charypar/embedded-playground/Readme.md

# Niche device firmware

## Flashing bootloader

Using a probe

```sh
make flash-bootloader
```

## Flashing firmware

For Spinny, for example:

With a probe:

```sh
make flash-spinny
```

Over USB

```sh
make upload-spinny
```
