charypar/embedded-playground/blinky/README.md

# Device specific code

This is not strictly speaking completely separated yet.
