charypar/embedded-playground/cross/README.md

# Cross-platform code

This contains code that runs just as happily on device as it does on the host. Currently mainly used to run tests on the host.
