charypar/embedded-playground/spinny/software/README.md

# Spinny, the rotary USB controller prototype

A device with a rotary encoder and four buttons all directly wired to the MCU.

Uses stm32f103c8t6 microcontroller with ARM Cortex-M0+ core.
