charypar/embedded-playground/spinny/hardware/production/enclosure/back-case.stl

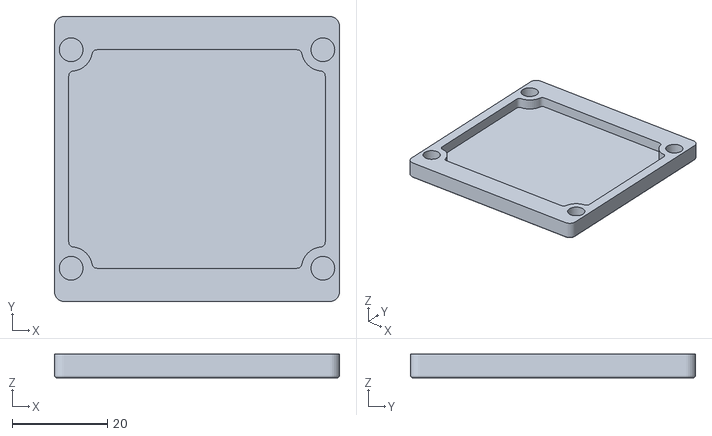
[picture p1: CAD file, 2022-08-29]
spinny/hardware/production/enclosure/back-case.stl
60.0 x 60.0 x 5.00
