charypar/embedded-playground/spinny/hardware/production/enclosure/button.stl

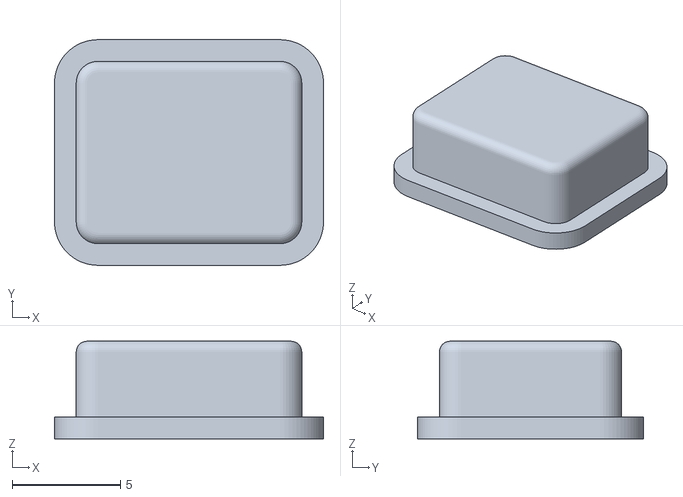
[picture p2: CAD file, 2022-08-29]
spinny/hardware/production/enclosure/button.stl
12.4 x 10.4 x 4.50
