charypar/embedded-playground/spinny/hardware/production/enclosure/front-case.stl

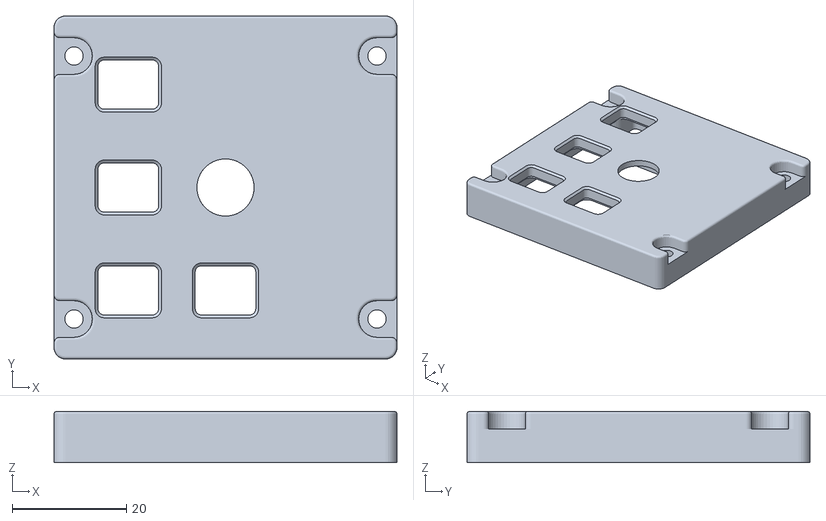
[picture p3: CAD file, 2022-08-29]
spinny/hardware/production/enclosure/front-case.stl
60.0 x 60.0 x 9.00
