charypar/embedded-playground/spinny/hardware/production/enclosure/knob.stl

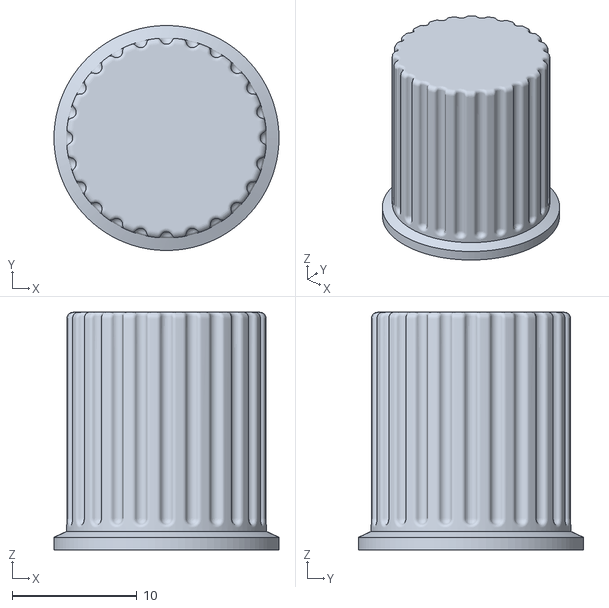
[picture p4: CAD file, 2022-08-29]
spinny/hardware/production/enclosure/knob.stl
18.0 x 18.0 x 19.0
