charypar/embedded-playground/spinny/hardware/Spinny.kicad_pcb

## KiCad design spinny/hardware/Spinny.kicad_pcb (2022-08-29)

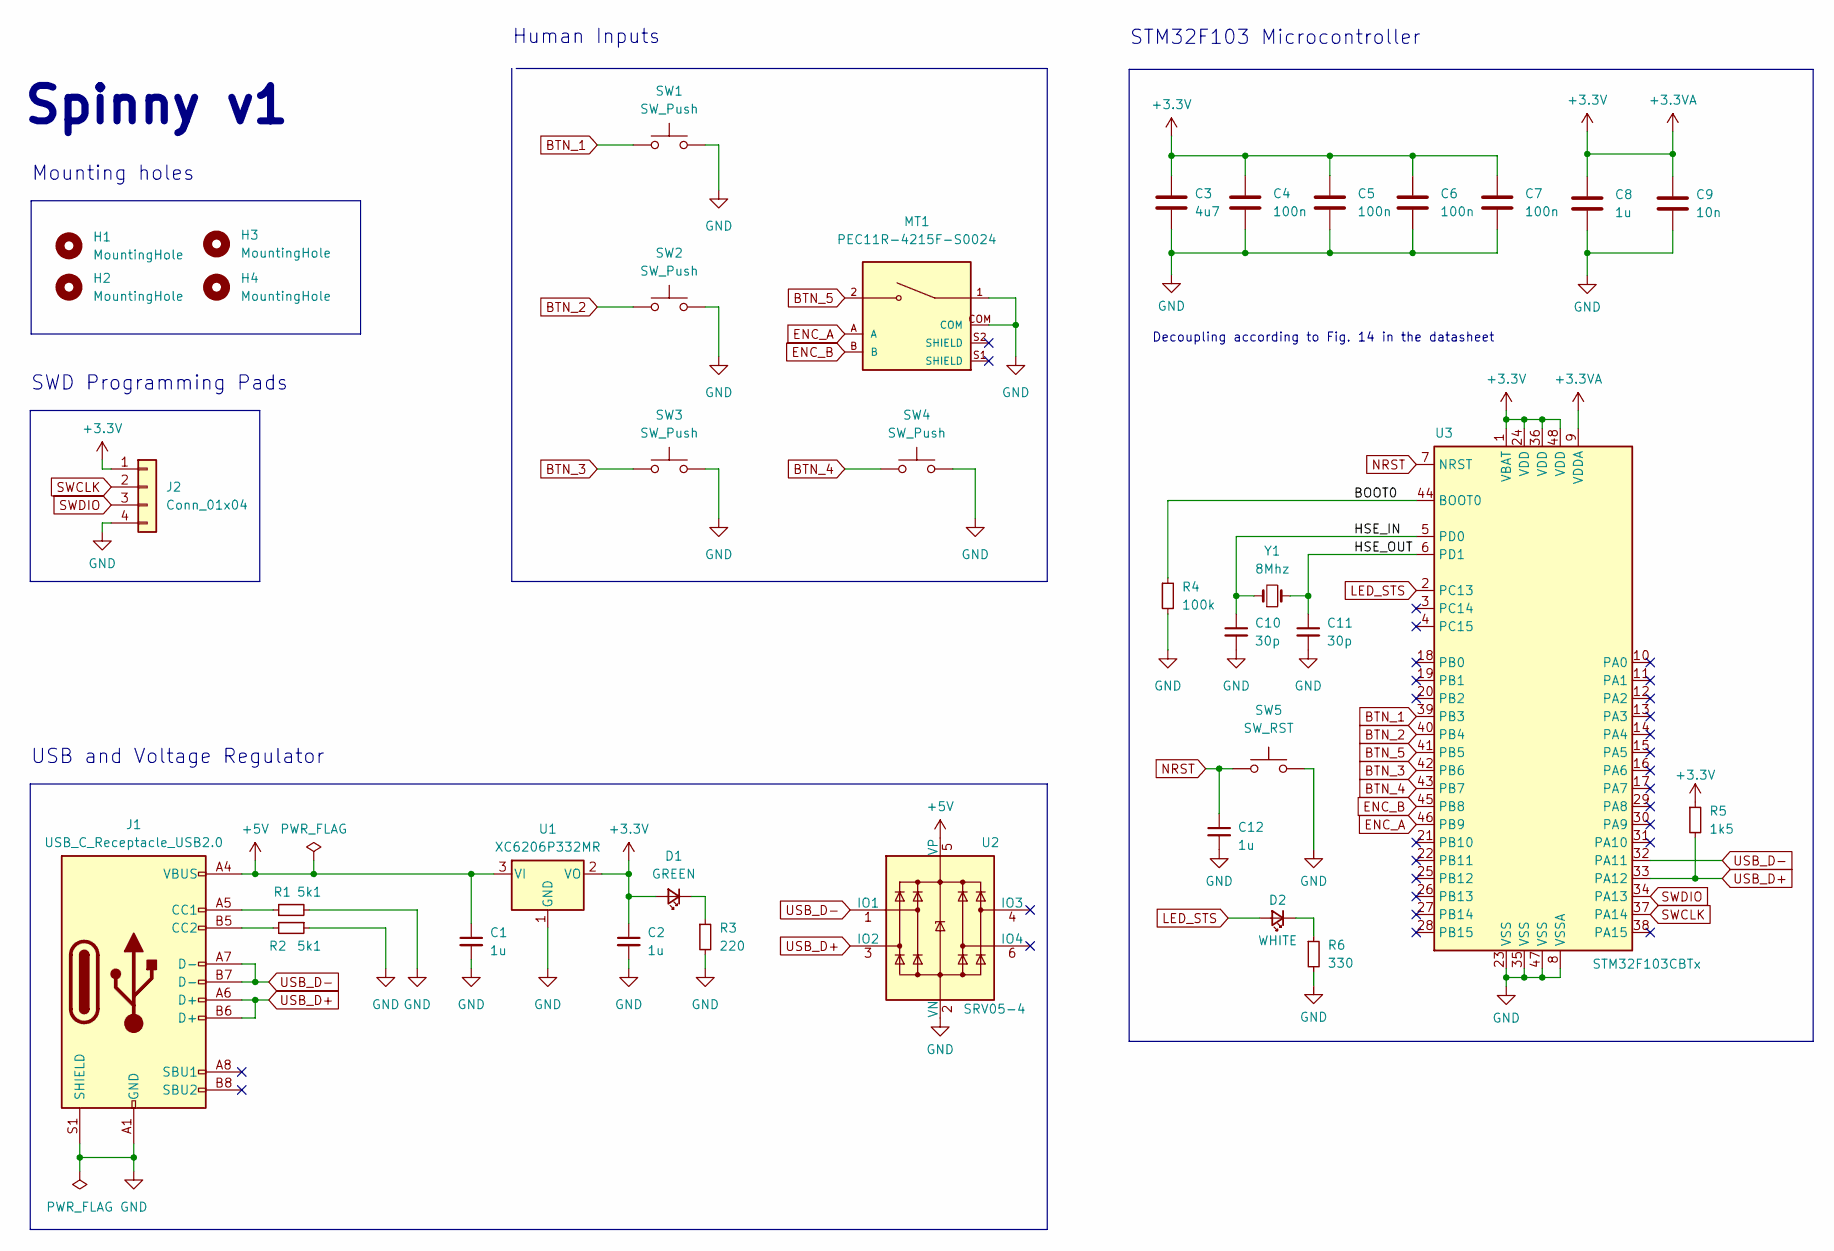
[picture p5: schematic Spinny.kicad_sch, Spinny Flight Simulation Control]

Parts:
C1, C2, C8, C12: 1u; C_0402_1005Metric; LCSC C52923
C3: 4u7; C_0603_1608Metric; LCSC C19666
C4, C5, C6, C7: 100n; C_0402_1005Metric; LCSC C1525
C9: 10n; C_0402_1005Metric; LCSC C15195
C10, C11: 30p; C_0402_1005Metric; LCSC C1570
D1: GREEN; LED_0603_1608Metric; LCSC C72043
D2: WHITE; LED_0603_1608Metric; LCSC C2290
H1, H2, H3, H4: MountingHole; MountingHole_3.2mm_M3
J1: USB_C_Receptacle_USB2.0; USB_C_Receptacle_HRO_TYPE-C-31-M-12; LCSC C709357
J2: Conn_01x04; PinHeader_1x04_P2.54mm_Vertical
MT1: PEC11R-4215F-S0024; XDCR_PEC11R-4215F-S0024; PARTREV Rev. 09/19
R1, R2: 5k1; R_0402_1005Metric; LCSC C25905
R3: 220; R_0402_1005Metric; LCSC C25091
R4: 100k; R_0402_1005Metric; LCSC C25741
R5: 1k5; R_0402_1005Metric; LCSC C25867
R6: 330; R_0402_1005Metric; LCSC C25104
SW1, SW2, SW3, SW4: SW_Push; SW_TS02-66-43-BK-100-LCR-D
SW5: SW_RST; SMD-SW-4_5.1x5.1x1.5; LCSC C318884
U1: XC6206P332MR; SOT-23; LCSC C5446
U2: SRV05-4; SOT-23-6; LCSC C85364
U3: STM32F103CBTx; LQFP-48_7x7mm_P0.5mm; LCSC C8304
Y1: 8Mhz; Crystal_SMD_5032-2Pin_5.0x3.2mm; LCSC C115962

Connections:
+5V: C1.1, J1.A4 (VBUS), J1.A9 (VBUS), J1.B4 (VBUS), J1.B9 (VBUS), U1.3 (VI), U2.5 (VP)
/BOOT0: R4.1, U3.44 (BOOT0)
/HSE_IN: C10.1, U3.5 (PD0), Y1.1
/HSE_OUT: C11.1, U3.6 (PD1), Y1.2
BTN_1: SW1.1, U3.39 (PB3)
BTN_2: SW2.1, U3.40 (PB4)
BTN_3: SW3.1, U3.42 (PB6)
BTN_4: SW4.1, U3.43 (PB7)
BTN_5: MT1.2, U3.41 (PB5)
ENC_A: MT1.A, U3.46 (PB9)
ENC_B: MT1.B, U3.45 (PB8)
GND: C1.2, C2.2, C3.2, C4.2, C5.2, C6.2, C7.2, C8.2, C9.2, C10.2, C11.2, C12.2, J1.A1 (GND), J1.A12 (GND), J1.B1 (GND), J1.B12 (GND), J1.S1 (SHIELD), J2.4, MT1.1, MT1.COM, R1.2, R2.1, R3.2, R4.2, R6.2, SW1.2, SW2.2, SW3.2, SW4.2, SW5.2, U1.1 (GND), U2.2 (VN), U3.8 (VSSA), U3.23 (VSS), U3.35 (VSS), U3.47 (VSS)
LED_STS: D2.2 (A), U3.2 (PC13)
NRST: C12.1, SW5.1, U3.7 (NRST)
unnamed: D1.1 (K), R3.1
unnamed: D2.1 (K), R6.1
unnamed: J1.A5 (CC1), R1.1
unnamed: J1.B5 (CC2), R2.2
SWCLK: J2.2, U3.37 (PA14)
SWDIO: J2.3, U3.34 (PA13)
USB_D+: J1.A6 (D+), J1.B6 (D+), R5.2, U2.3 (IO2), U3.33 (PA12)
USB_D-: J1.A7 (D-), J1.B7 (D-), U2.1 (IO1), U3.32 (PA11)

Notes on the sheet:
SWD Programming Pads
Decoupling according to Fig. 14 in the datasheet
Spinny v1
Human Inputs
STM32F103 Microcontroller
Mounting holes
USB and Voltage Regulator

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
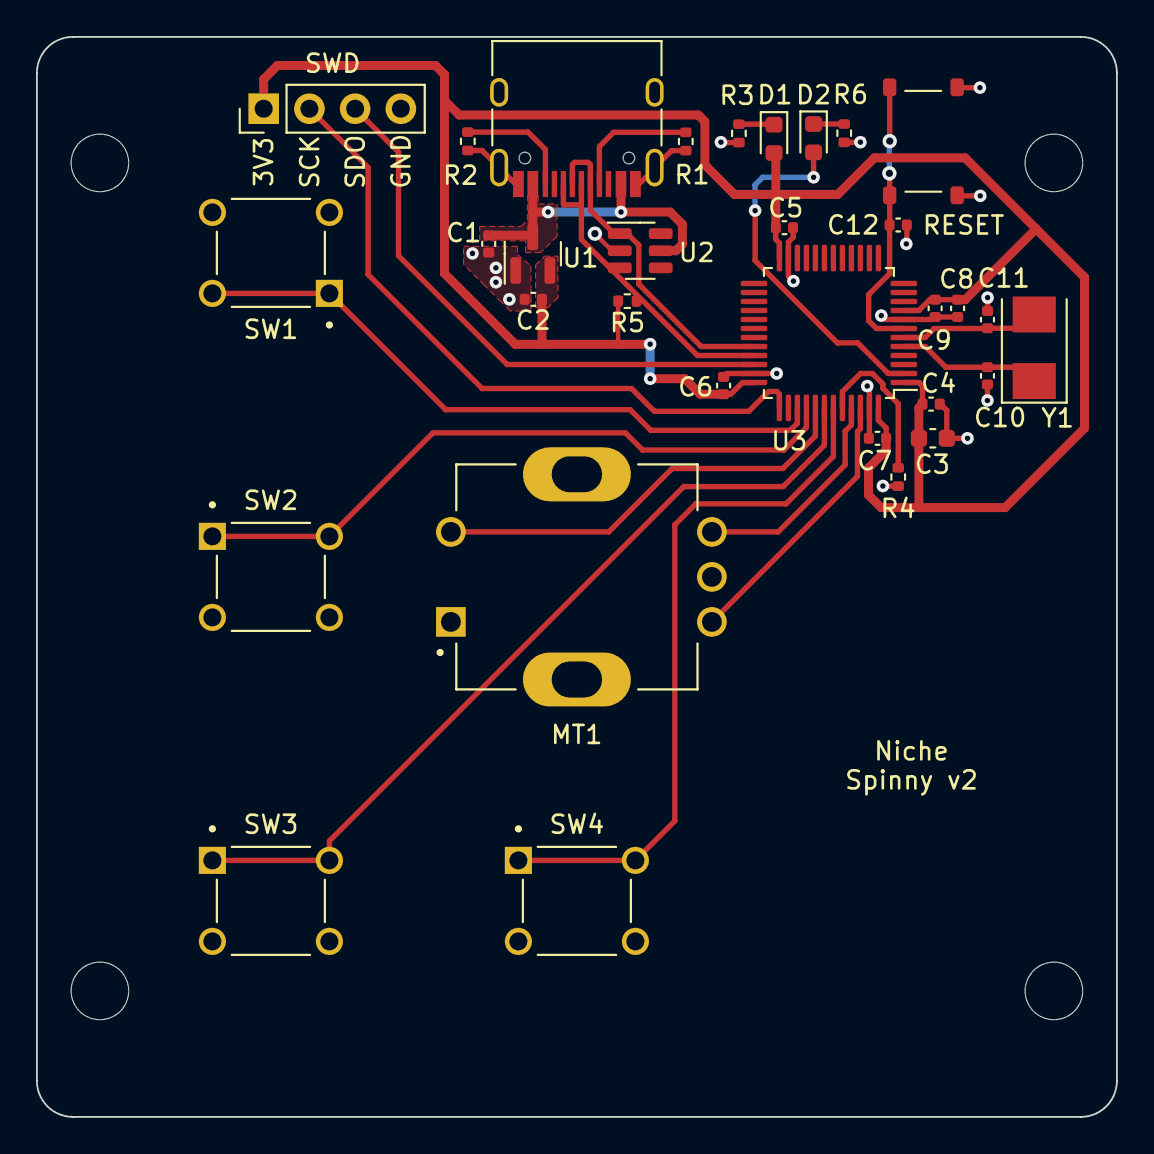
[picture p6: board Spinny.kicad_pcb from above]

Board: 2 copper layers, 60.0 x 60.0 mm, 36 parts (0 on the bottom side), 23 nets.
