charypar/embedded-playground/(commit log)

2022-01-30 Blinky v2 with (broken) matrix wiring
    [main.rs]
2022-01-31 Switch from bit bang SPI to hardware SPI
2022-02-13 Switch to RTIC, add debouncing in the process
2022-02-21 Add reading rotary as button presses, clean up a bit
2022-02-21 Remove arduino code
2022-02-21 Make the device a composite with Interface Association Descriptors
2022-02-23 Fix bug where writes into serial port break... everything
    [main.rs]
2022-02-27 Switch to HID Joystick
2022-03-06 Buffer encoder output and replay it at reliable rate
2022-03-08 Split code to device and cross-platform to allow unit tests on host
2022-05-22 Remove cargo workspace, add Spinny device, add DAPlink probe debugging conifg
2022-05-24 Speed up input scanning and track real time for measuring how long things take
2022-07-10 Add Spinny hardware design
    [Spinny.kicad_pcb, Spinny.kicad_sch]
2022-07-11 Add production files
    [Spinny-B_Cu.gbl, Spinny-B_Mask.gbs, Spinny-B_Paste.gbp, Spinny-B_Silkscreen.gbo, Spinny-Edge_Cuts.gm1, Spinny-F_Cu.gtl, Spinny-F_Mask.gts, Spinny-F_Paste.gtp]
2022-07-11 Ignore KiCad backup files
2022-07-11 Update part numbers and automate Gerber, BOM and CPL files
    [Spinny-B_Mask.gbs, Spinny-CmtUser.gbr, Spinny-CuBottom.gbl, Spinny-CuTop.gtl, Spinny-EdgeCuts.gm1, Spinny-MaskBottom.gbs, Spinny-MaskTop.gts, Spinny-NPTH-drl_map.gbr]
2022-07-25 Adjust board to fit enclosure beter
    [Spinny-CmtUser.gbr, Spinny-CuBottom.gbl, Spinny-CuTop.gtl, Spinny-EdgeCuts.gm1, Spinny-MaskBottom.gbs, Spinny-MaskTop.gts, Spinny-PasteBottom.gbp, Spinny-PasteTop.gtp]
2022-07-25 Move production files
    [Spinny-CmtUser.gbr, Spinny-CuBottom.gbl, Spinny-CuTop.gtl, Spinny-EdgeCuts.gm1, Spinny-MaskBottom.gbs, Spinny-MaskTop.gts, Spinny-PasteBottom.gbp, Spinny-PasteTop.gtp]
2022-07-26 Add enclosure files
    [back-case.stl, button.stl, front-case.stl, knob.stl]
2022-08-07 Spinny v2: Fix wiring of tactile switches
    [Spinny-CmtUser.gbr, Spinny-CuBottom.gbl, Spinny-CuTop.gtl, Spinny-EdgeCuts.gm1, Spinny-MaskBottom.gbs, Spinny-MaskTop.gts, Spinny-PasteBottom.gbp, Spinny-PasteTop.gtp]
2022-08-07 Port Spinny onto stm32 - basic blinking LED
2022-08-07 Spinny v2: fixes
    [Spinny-CmtUser.gbr, Spinny-CuBottom.gbl, Spinny-CuTop.gtl, Spinny-EdgeCuts.gm1, Spinny-MaskBottom.gbs, Spinny-MaskTop.gts, Spinny-PasteBottom.gbp, Spinny-PasteTop.gtp]
2022-08-29 Enclosure v2
    [back-case.stl, button.stl, front-case.stl, knob.stl]
2022-08-29 Spinny V2 with stm32f104cbt6 instead of c8t6, because JLCPCB is random
    [Spinny-CmtUser.gbr, Spinny-CuBottom.gbl, Spinny-CuTop.gtl, Spinny-EdgeCuts.gm1, Spinny-MaskBottom.gbs, Spinny-MaskTop.gts, Spinny-PasteBottom.gbp, Spinny-PasteTop.gtp]
2022-09-11 Spinny V2 schema file I forgot to commit
    [Spinny.kicad_sch]
2022-10-09 Re-enable buttons, only send HID reports when new state is available
2022-10-15 Factor out stm32 specific peripheral setup
2022-10-31 Fix rotary reporting and add a slight velocity curve
    [device.rs, inputs.rs, main.rs, rotary.rs]
